EstebanValverde/Tourette-stimulator/schematic.png

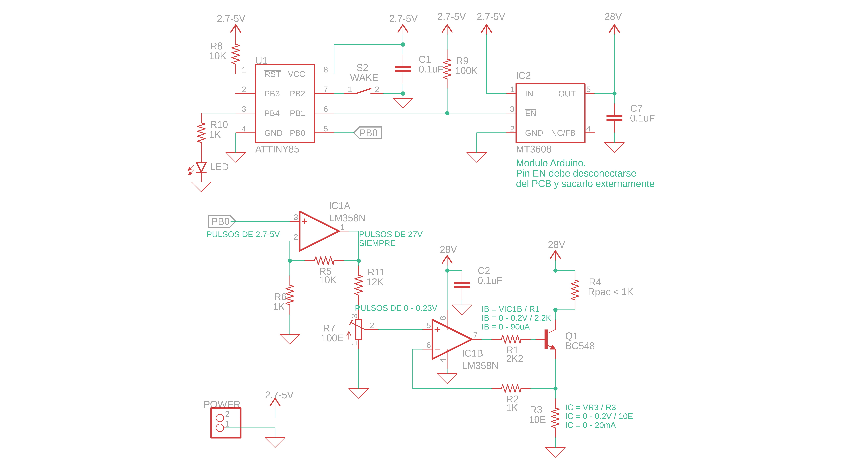
schematic.png
